Sync-/powermetering/(threads)

Thread 1 (2019-06-04):

error

Hojat1995, 2019-06-04:
hi,I am hojat and thank you for this project, i am working on ade9000 by arduino , i saw you have worked on stm so i downloaded that , but when i open eagle files that give me one error:

Loading C:/Users/hh/Downloads/powermetering-master/powermetering-master/stm32.sch ...

Error:

**line 1, column 1: Start tag expected.**

can you help me ,why?

luksal, 2019-06-04:
It's made with KiCAD not eagle

Sync-, 2019-06-04:
Luksal is correct, this project is designed in KiCAD.

Hojat1995, 2019-06-04:
oops, THANKS.I didn't know this software, I will download it and test it,THANKS again.    On Tuesday, June 4, 2019, 8:36:19 PM GMT+4:30, Sync- <notifications@github.com> wrote:

Closed #1.

—
You are receiving this because you authored the thread.
Reply to this email directly, view it on GitHub, or mute the thread.

Hojat1995, 2019-06-04:
My win recognize under software . Can you tell me which software do you use?I use altium and kail ,eagle and codvision and atmel are install.
    On Tuesday, June 4, 2019, 8:36:18 PM GMT+4:30, Sync- <notifications@github.com> wrote:

Luksal is correct, this project is designed in KiCAD.

—
You are receiving this because you authored the thread.
Reply to this email directly, view it on GitHub, or mute the thread.

Closed 2019-06-04.

Thread 2 (2019-06-05):

GPN19 slides

luksal, 2019-06-05:
I saw that there was a talk about this powermeter project at the GPN19, which is unfortunately not available as a recording. Is it possible to get the slides and other informations about this?

Sync-, 2019-06-05:
The slides are here: https://pretalx.entropia.de/gpn19/talk/TFASVY/
However there is not much information beyond what you can find in the git repo.

luksal, 2019-06-05:
Clicking on the slides link gives a 404

Sync-, 2019-06-05:
Huh, that seems like a problem on their end, I'll see what I can do.

Closed 2019-06-05.

Thread 3 (2019-06-20):

Stuff to fix

Sync-, 2019-06-20:
- [ ] Fix SPI connection

- [ ] Connect a Magjack LED to the PHY and STM

- [ ] Pinheader with GPIOs

- [ ] VTref for the debugger

- [ ] USB Host

- [ ] Ruggedness improvements (MOV, ESD)

Thread 4 (2019-09-07):

Add BOM or missing component values

joa77, 2019-09-07:
Can you add a complete BOM, add the missing values in the schematics or share a Digikey cart?

Thread 12 (2020-01-04):

Power Factor readout failed

MarkusBec, 2020-01-04:
After some time Power Factor readings Fail.
It can only be recovered by a reset of the STM.

MarkusBec, 2020-01-04:
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
