Sync-/powermetering/powermetering.kicad_pcb

## KiCad design powermetering.kicad_pcb (2020-01-22)

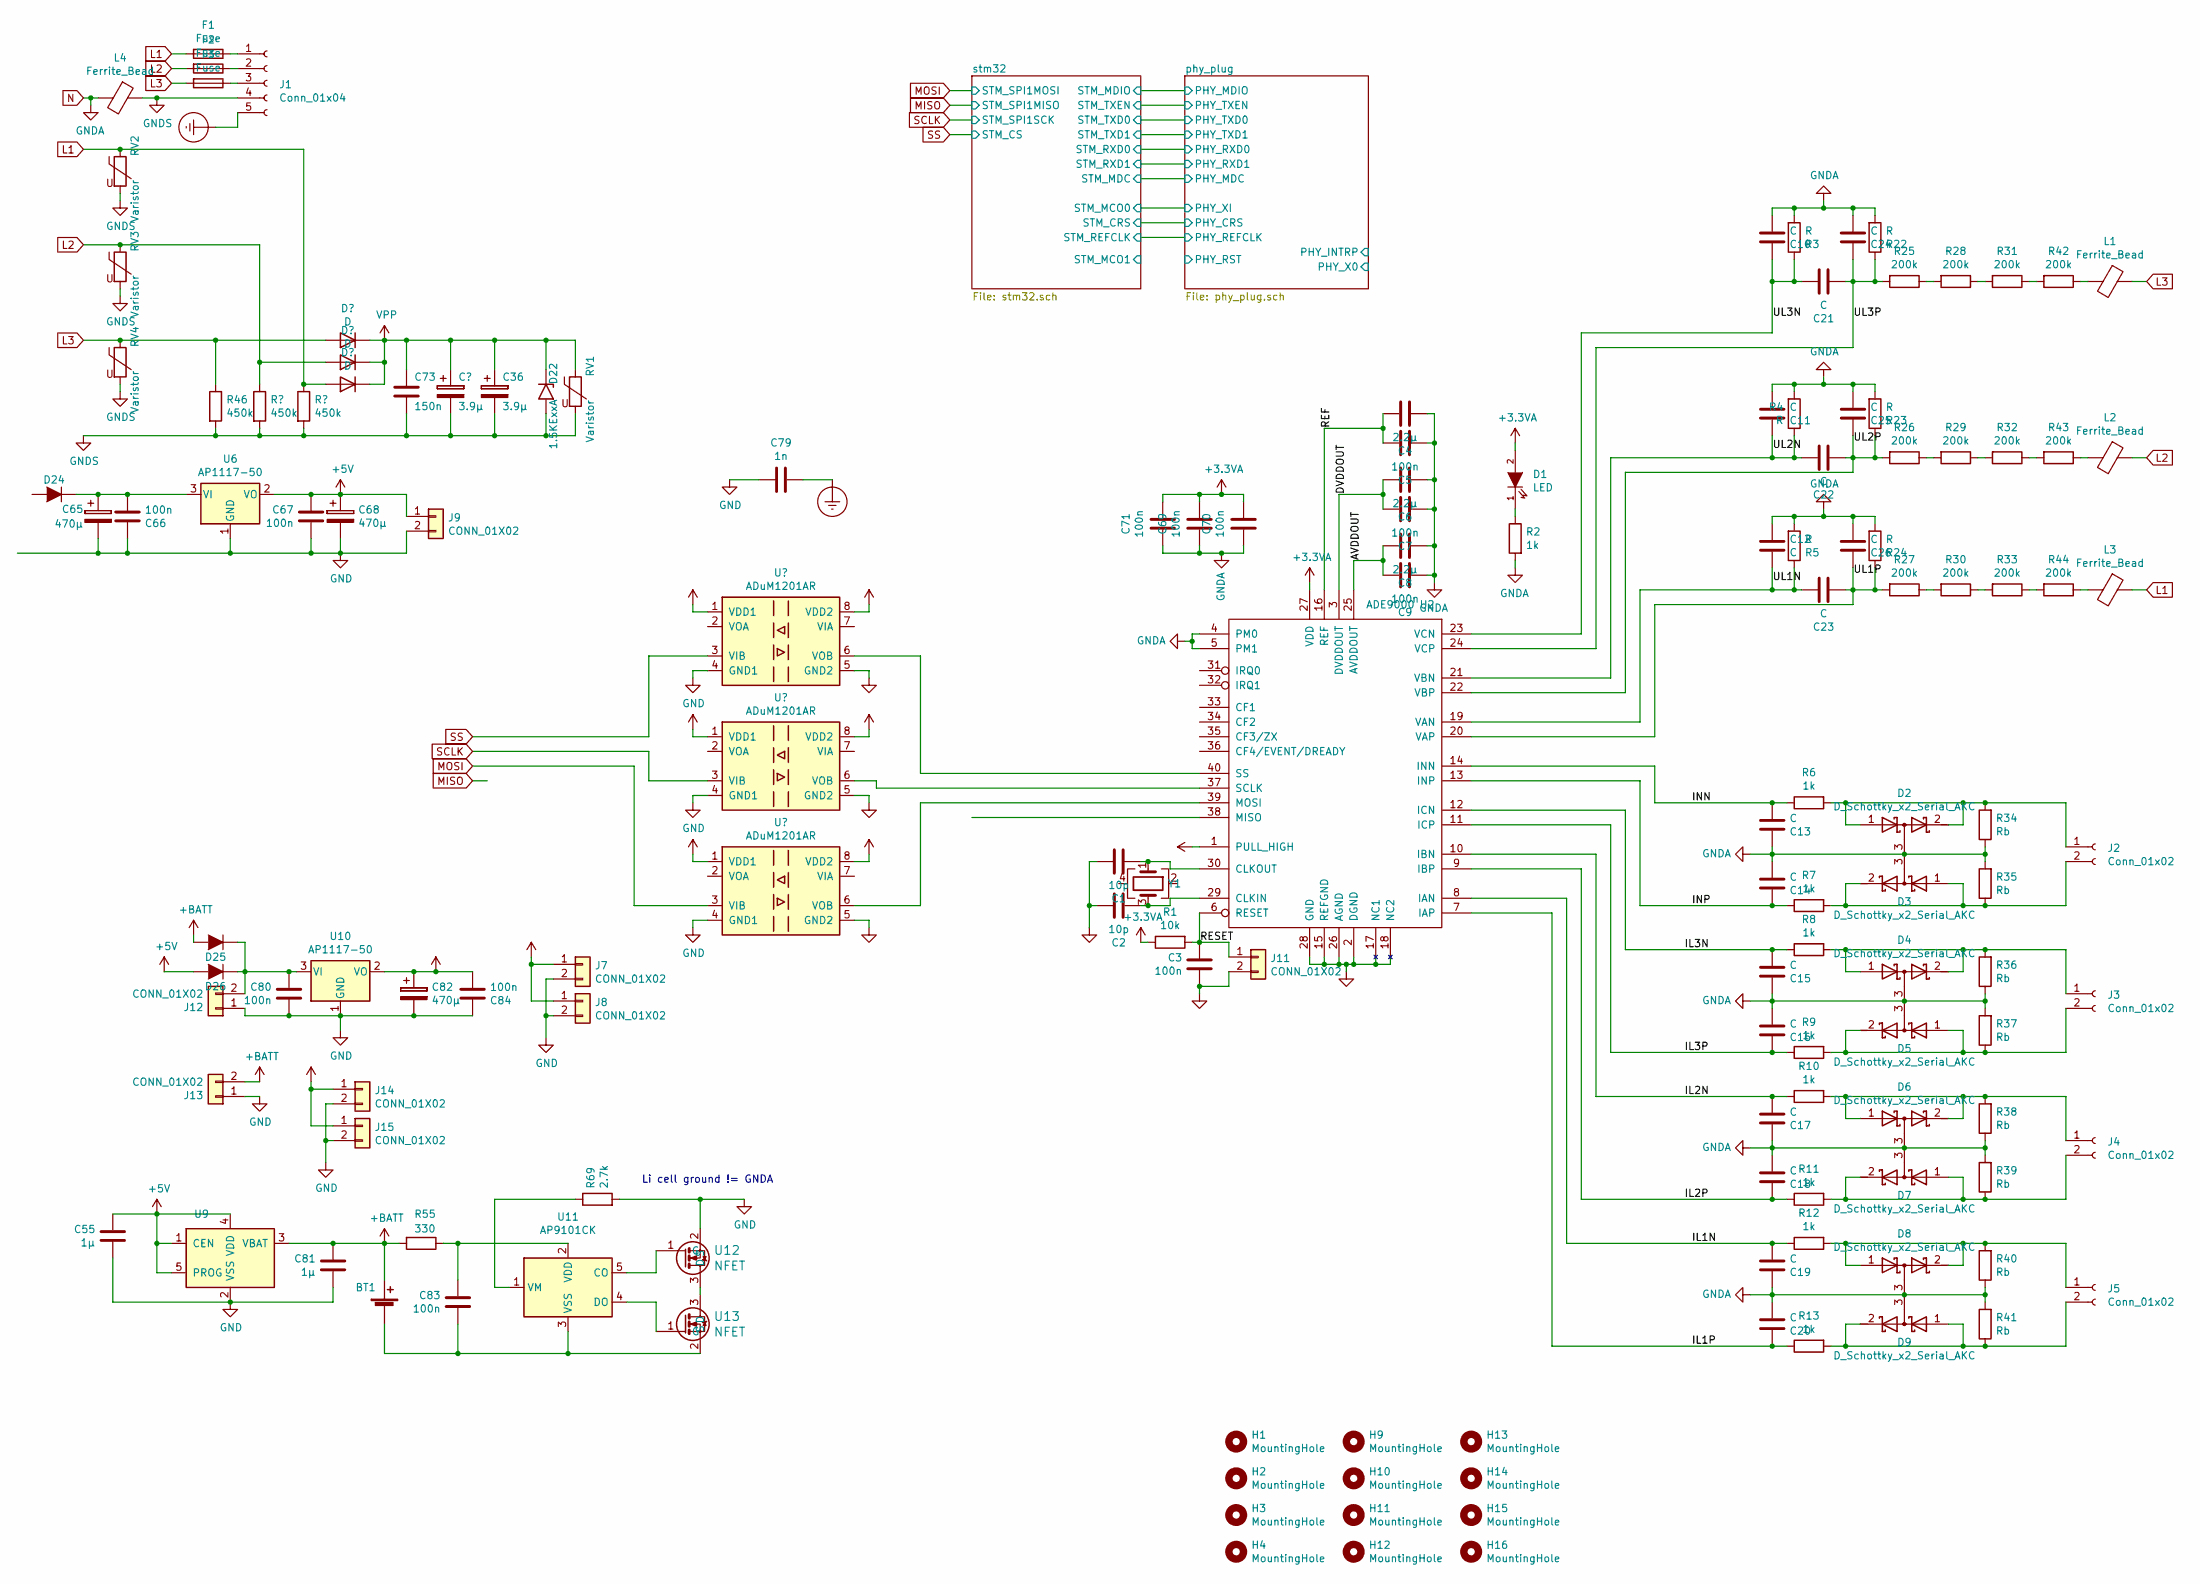
[picture p1: schematic powermetering.sch]

Parts:
BT1: Battery_Cell; 18650_keystone_54
C1, C2: 10p; C_0603
C3, C5, C7, C9, C69, C70, C71: 100n; C_0603
C4, C6, C8: 2.2µ; C_0603
C10, C11, C12, C13, C14, C15, C16, C17, C18, C19, C20, C21, C22, C23, C24, C25, C26: C; C_0603
C36: 3.9µ; CP_Elec_8x10
C55, C81: 1µ; C_0805
C65: 470µ; CP_Elec_8x10
C66, C67, C80, C83, C84: 100n; C_0805
C68, C82: 470µ; CP_Elec_8x10.5
C73: 150n; C_1808
C79: 1n; C_1806_4516Metric
D1: LED; LED-0805
D2, D3, D4, D5, D6, D7, D8, D9: D_Schottky_x2_Serial_AKC; SOT-23
D22: 1.5KExxA; D_SMC
D24, D25, D26: D; SMA_Standard
F1, F2, F3: Fuse; Fuse_SunFuse-6HP
H1, H2, H3, H4, H9, H10, H11, H12, H13, H14, H15, H16: MountingHole; MountingHole_5.5mm
J1: Conn_01x04; RM5.08_1x5_UP
J2, J3, J4, J5: Conn_01x02; RM5.08_1x2_UP
J7, J8, J9, J11, J12, J13, J14, J15: CONN_01X02; Pin_Header_Straight_1x02
L1, L2, L3, L4: Ferrite_Bead; C_0805
R1: 10k; R_0603
R2, R6, R7, R8, R9, R10, R11, R12, R13: 1k; R_0603
R3, R4, R5, R22, R23, R24: R; R_0603
R25, R26, R27, R28, R29, R30, R31, R32, R33, R42, R43, R44: 200k; R_1206
R34, R35, R36, R37, R38, R39, R40, R41: Rb; R_0612_1632Metric
R46: 450k; R_1206
R55: 330; R_0805
R69: 2.7k; R_0805
RV1, RV2, RV3, RV4: Varistor; RV_Disc_D12mm_W3.9mm_P7.5mm
U2: ADE9000; QFN-40-1EP_6x6mm_Pitch0.5mm
U6, U10: AP1117-50; SOT-223-3_TabPin2
U9: MCP73811T-420I-OT; SOT-23-5
U11: AP9101CK; SOT-23-5
U12, U13: NFET; SOT-23
Y1: Crystal; Crystal_SMD_3225-4Pin_3.2x2.5mm

Connections:
+3.3VA: C69.2, C70.2, C71.2, D1.2 (A), R1.1, U2.1 (PULL_HIGH), U2.27 (VDD); also elsewhere on the board
+3V3: C82.1, C84.2, J7.1, J8.1, J14.1, J15.1, U10.2 (VO); also elsewhere on the board
+5V: C55.1, C67.1, C68.1, D26.2 (A), J9.1, U6.2 (VO), U9.1 (CEN), U9.4 (VDD), U9.5 (PROG)
+BATT: BT1.1 (+), C81.1, D25.2 (A), J13.2, R55.2, U9.3 (VBAT)
/AVDDOUT: C8.2, C9.2, U2.25 (AVDDOUT)
/DVDDOUT: C6.2, C7.2, U2.3 (DVDDOUT)
/IL1N: C19.1, R12.1, U2.8 (IAN)
/IL1P: C20.2, R13.1, U2.7 (IAP)
/IL2N: C17.1, R10.1, U2.10 (IBN)
/IL2P: C18.2, R11.1, U2.9 (IBP)
/IL3N: C15.1, R8.1, U2.12 (ICN)
/IL3P: C16.2, R9.1, U2.11 (ICP)
/INN: C13.1, R6.1, U2.14 (INN)
/INP: C14.2, R7.1, U2.13 (INP)
/REF: C4.2, C5.2, U2.16 (REF)
/RESET: C3.2, J11.1, R1.2, U2.6 (RESET)
/UL1N: C12.2, C23.2, R5.1, U2.19 (VAN)
/UL1P: C23.1, C26.2, R24.1, R27.2, U2.20 (VAP)
/UL2N: C11.2, C22.2, R4.1, U2.21 (VBN)
/UL2P: C22.1, C25.2, R23.1, R26.2, U2.22 (VBP)
/UL3N: C10.2, C21.2, R3.1, U2.23 (VCN)
/UL3P: C21.1, C24.2, R22.1, R25.2, U2.24 (VCP)
Earth_Protective: C79.2, J1.5
GND: C55.2, C65.2, C66.1, C67.2, C68.2, C79.1, C80.2, C81.2, C82.2, C84.1, J7.2, J8.2, J9.2, J12.1, J13.1, J14.2, J15.2, R69.2, U6.1 (GND), U9.2 (VSS), U10.1 (GND), U12.2 (S); also elsewhere on the board
L1: F1.2, L3.1, RV2.1; also elsewhere on the board
L2: F2.2, L2.1, RV3.1; also elsewhere on the board
N: C1.2, C2.2, C3.1, C4.1, C5.1, C6.1, C7.1, C8.1, C9.1, C10.1, C11.1, C12.1, C13.2, C14.1, C15.2, C16.1, C17.2, C18.1, C19.2, C20.1, C24.1, C25.1, C26.1, C69.1, C70.1, C71.1, D2.3 (common), D3.3 (common), D4.3 (common), D5.3 (common), D6.3 (common), D7.3 (common), D8.3 (common), D9.3 (common), J11.2, L4.2, R2.2, R3.2, R4.2, R5.2, R22.2, R23.2, R24.2, R34.1, R35.2, R36.1, R37.2, R38.1, R39.2, R40.1, R41.2, U2.2 (DGND), U2.4 (PM0), U2.5 (PM1), U2.15 (REFGND), U2.17 (NC1), U2.18 (NC2), U2.26 (AGND), U2.28 (GND); also elsewhere on the board
unnamed: BT1.2 (-), C83.2, U11.3 (VSS), U13.2 (S)
unnamed: C1.1, U2.30 (CLKOUT), Y1.1
unnamed: C2.1, U2.29 (CLKIN), Y1.3
unnamed: C65.1, C66.2, D24.1 (K), U6.3 (VI)
unnamed: C80.1, D25.1 (K), D26.1 (K), J12.2, U10.3 (VI)
unnamed: C83.1, R55.1, U11.2 (VDD)
unnamed: D1.1 (K), R2.1
unnamed: D2.1 (A), D2.2 (K), J2.1, R6.2, R34.2
unnamed: D3.1 (A), D3.2 (K), J2.2, R7.2, R35.1
unnamed: D4.1 (A), D4.2 (K), J3.1, R8.2, R36.2
unnamed: D5.1 (A), D5.2 (K), J3.2, R9.2, R37.1
unnamed: D6.1 (A), D6.2 (K), J4.1, R10.2, R38.2
unnamed: D7.1 (A), D7.2 (K), J4.2, R11.2, R39.1
unnamed: D8.1 (A), D8.2 (K), J5.1, R12.2, R40.2
unnamed: D9.1 (A), D9.2 (K), J5.2, R13.2, R41.1
unnamed: F1.1, J1.1
unnamed: F2.1, J1.2
unnamed: F3.1, J1.3
unnamed: L1.2, R42.1
unnamed: L2.2, R43.1
unnamed: L3.2, R44.1
unnamed: R25.1, R28.2
unnamed: R26.1, R29.2
unnamed: R27.1, R30.2
unnamed: R28.1, R31.2
unnamed: R29.1, R32.2
unnamed: R30.1, R33.2
unnamed: R31.1, R42.2
unnamed: R32.1, R43.2
unnamed: R33.1, R44.2
unnamed: R69.1, U11.1 (VM)
unnamed 160: U2.37 (SCLK); also elsewhere on the board
unnamed 161: U2.38 (MISO); also elsewhere on the board
unnamed 162: U2.39 (MOSI); also elsewhere on the board
unnamed 163: U2.40 (SS); also elsewhere on the board
unnamed: U11.4 (DO), U13.1 (G)
unnamed: U11.5 (CO), U12.1 (G)
unnamed: U12.3 (D), U13.3 (D)

Notes on the sheet:
Li cell ground != GNDA

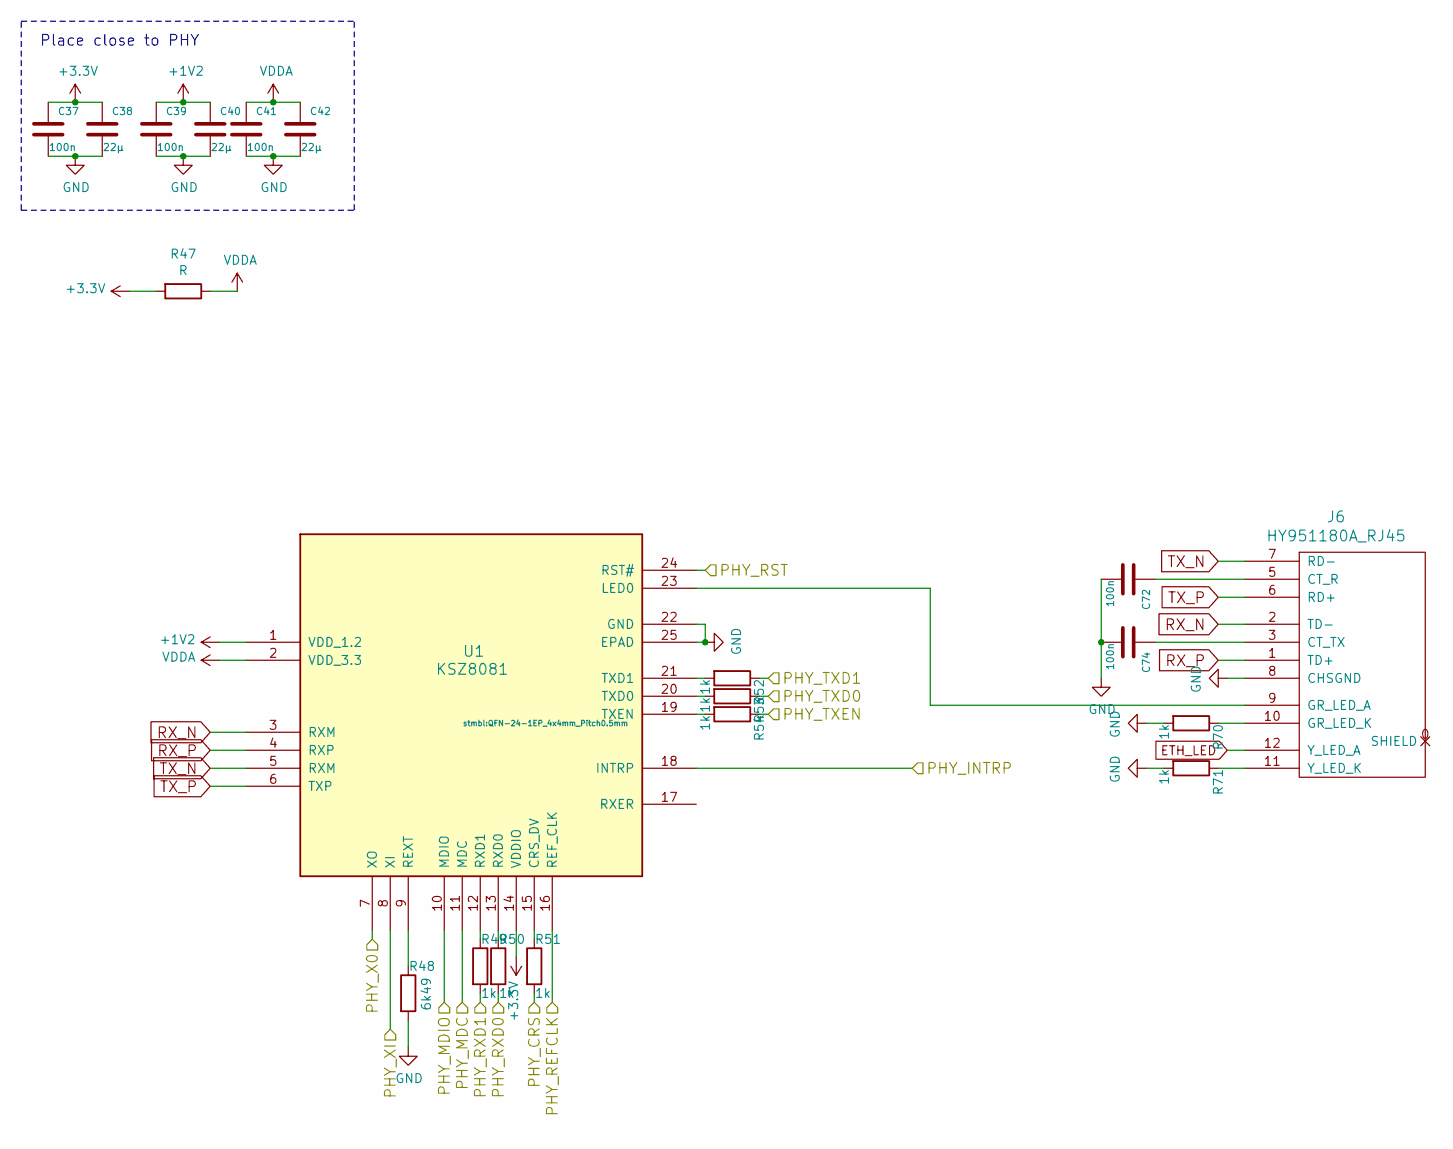
[picture p2: schematic phy_plug.sch]

Parts:
C37, C39, C41, C72, C74: 100n; C_0603
C38, C40, C42: 22µ; C_0805
J6: HY951180A_RJ45
R47: R; R_0603
R48: 6k49; R_0603
R49, R50, R51, R52, R53, R54, R70, R71: 1k; R_0603
U1: KSZ8081; QFN-24-1EP_4x4mm_Pitch0.5mm

Connections:
+1V2: C39.1, C40.1, U1.1 (VDD_1.2)
+3V3: C37.1, C38.1, R47.2, U1.14 (VDDIO); also elsewhere on the board
/PHY_CRS: R51.2; also elsewhere on the board
/PHY_INTRP: U1.18 (INTRP)
/PHY_MDIO: U1.10 (MDIO); also elsewhere on the board
/PHY_RST: U1.24 (RST#)
/PHY_TXD0: R53.1; also elsewhere on the board
/PHY_X0: U1.7 (XO)
/PHY_XI: U1.8 (XI); also elsewhere on the board
/STM_MDC: U1.11 (MDC); also elsewhere on the board
/STM_REFCLK: U1.16 (REF_CLK); also elsewhere on the board
/STM_RXD0: R50.2; also elsewhere on the board
/STM_RXD1: R49.2; also elsewhere on the board
/STM_TXD1: R52.1; also elsewhere on the board
/STM_TXEN: R54.1; also elsewhere on the board
ETH_LED: J6.12 (Y_LED_A); also elsewhere on the board
GND: C37.2, C38.2, C39.2, C40.2, C41.2, C42.2, C72.2, C74.2, J6.8 (CHSGND), R48.2, R70.2, R71.2, U1.22 (GND), U1.25 (EPAD); also elsewhere on the board
unnamed: C72.1, J6.5 (CT_R)
unnamed: C74.1, J6.3 (CT_TX)
unnamed: J6.9 (GR_LED_A), U1.23 (LED0)
unnamed: J6.10 (GR_LED_K), R70.1
unnamed: J6.11 (Y_LED_K), R71.1
unnamed: R48.1, U1.9 (REXT)
unnamed: R49.1, U1.12 (RXD1)
unnamed: R50.1, U1.13 (RXD0)
unnamed: R51.1, U1.15 (CRS_DV)
unnamed: R52.2, U1.21 (TXD1)
unnamed: R53.2, U1.20 (TXD0)
unnamed: R54.2, U1.19 (TXEN)
RX_N: J6.2 (TD-), U1.3 (RXM)
RX_P: J6.1 (TD+), U1.4 (RXP)
TX_N: J6.7 (RD-), U1.5 (RXM)
TX_P: J6.6 (RD+), U1.6 (TXP)
VDDA: C41.1, C42.1, R47.1, U1.2 (VDD_3.3)

Notes on the sheet:
Place close to PHY

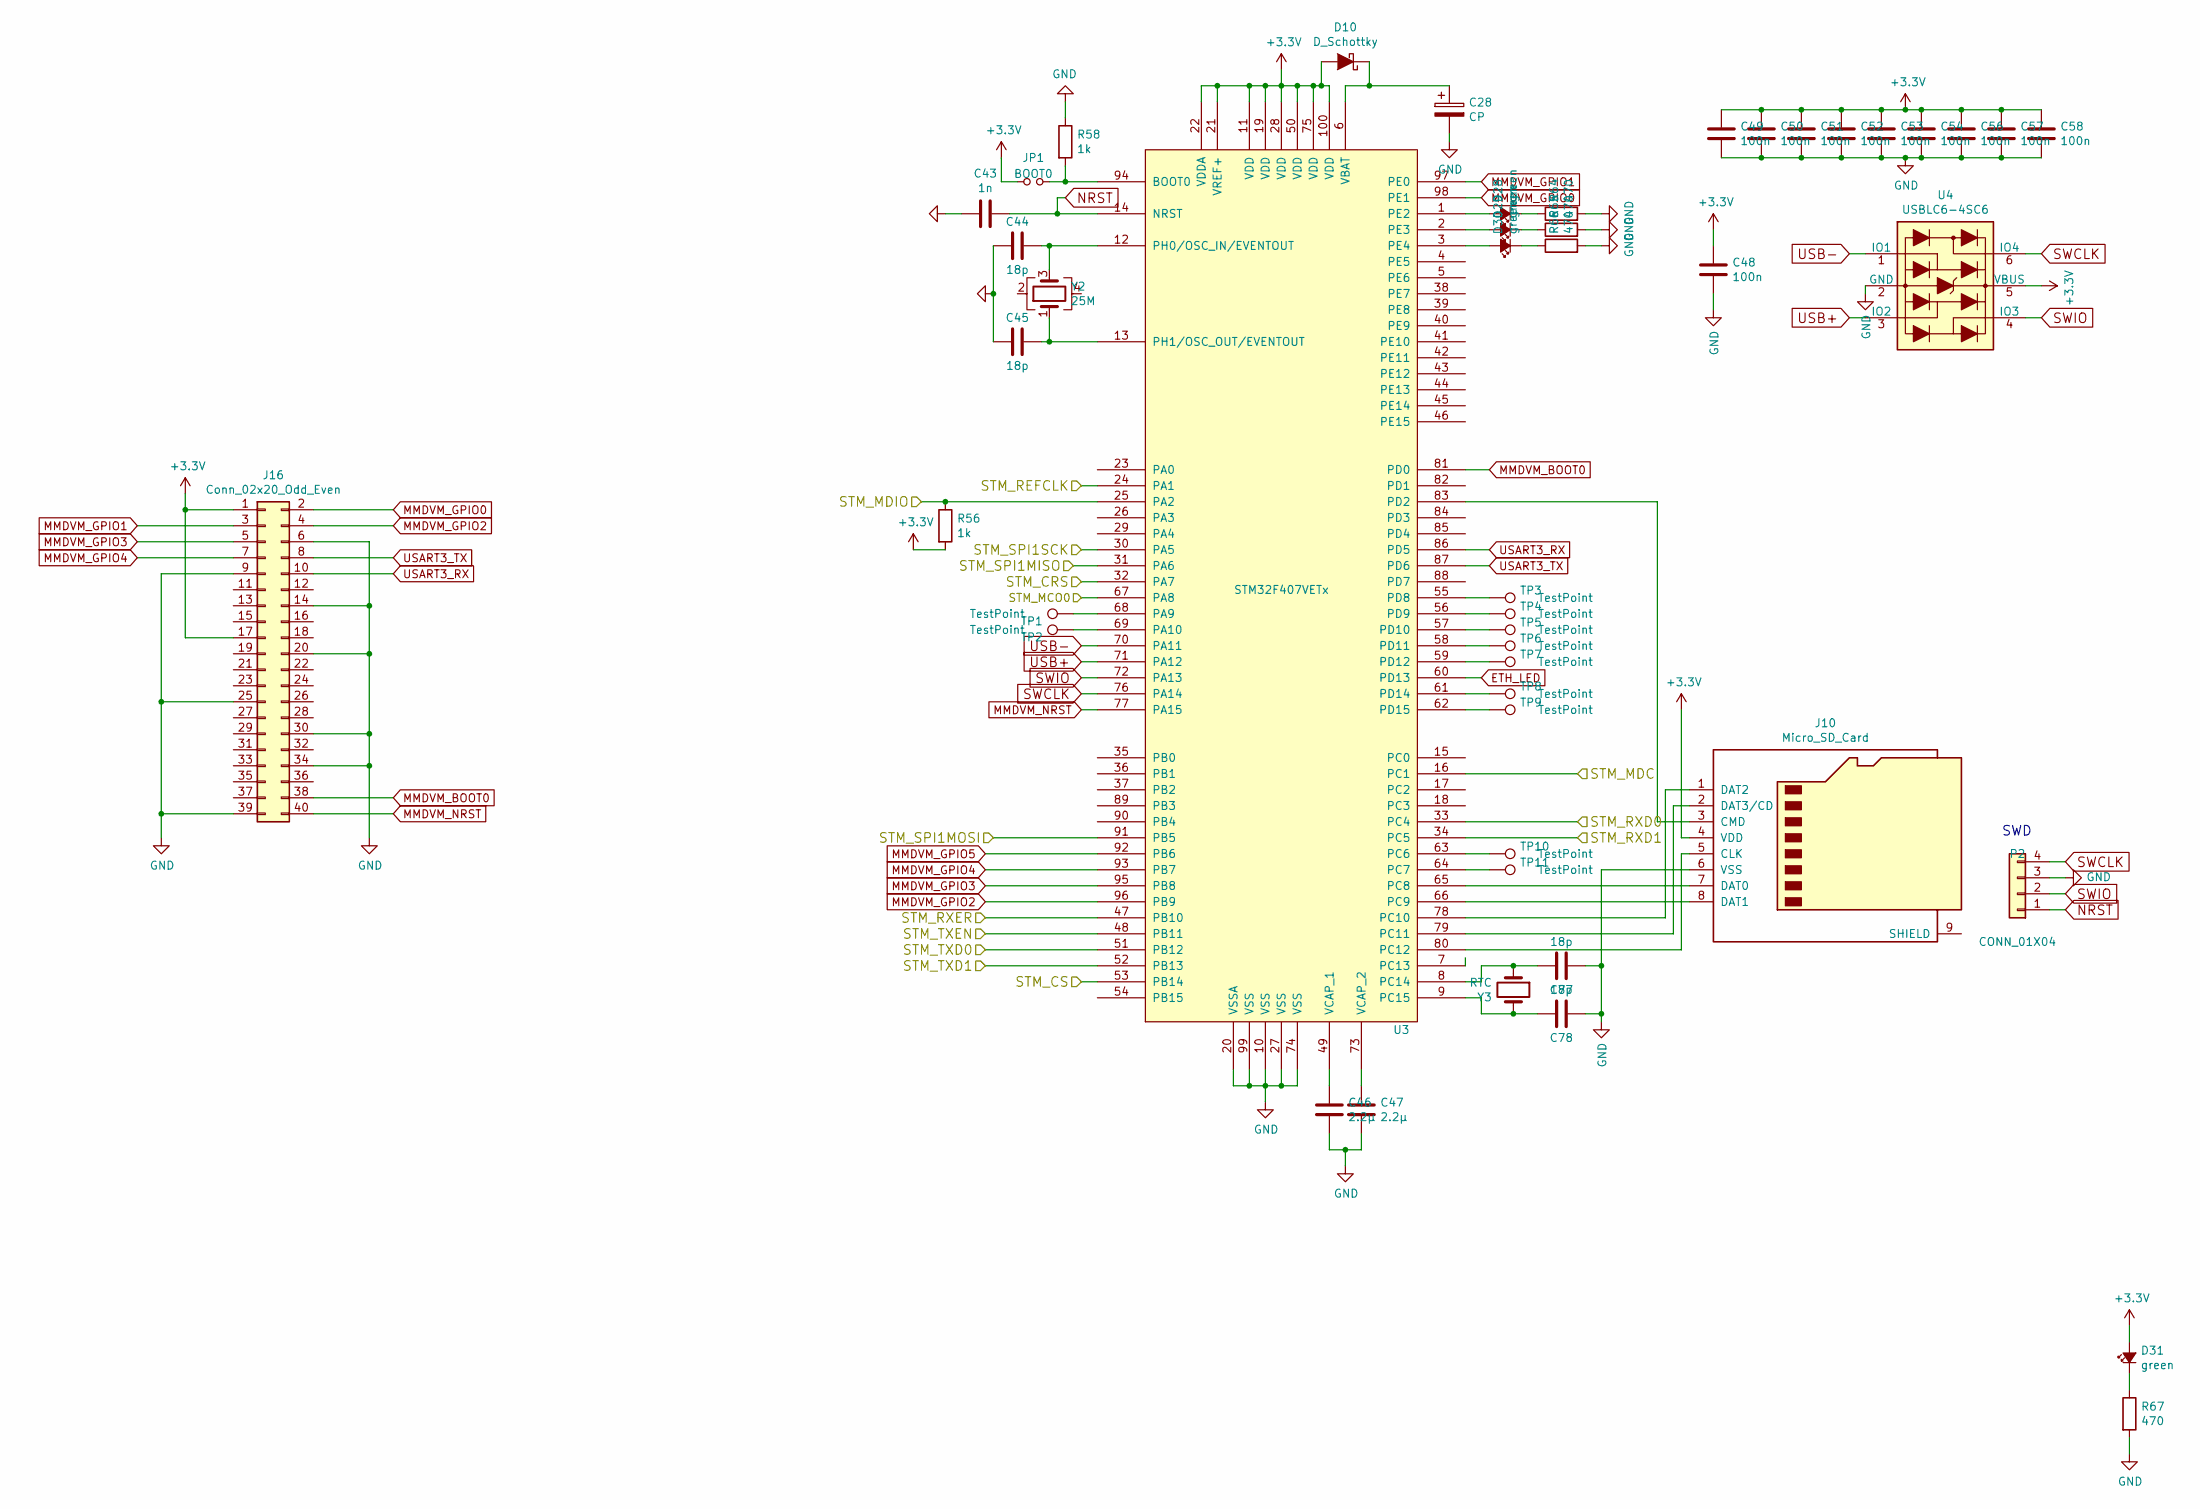
[picture p3: schematic stm32.sch, STM32 Ethernet BOB]

Parts:
C28: CP
C43: 1n; C_0603; Tolerance X5R; Voltage 50V
C44, C45, C77, C78: 18p; C_0603; Tolerance X5R; Voltage 50V
C46, C47: 2.2µ; C_0603; Tolerance X5R; Voltage 25V
C48, C49, C50, C51, C52, C53, C54, C56, C57, C58: 100n; C_0603; Tolerance X5R; Voltage 50V
D10: D_Schottky
D28, D29, D30, D31: green; LED-0805
J10: Micro_SD_Card; microSD_HC_Hirose_DM3BT-DSF-PEJS
J16: Conn_02x20_Odd_Even; PinHeader_2x20_P2.54mm_Vertical
JP1: BOOT0; SOLDER_JUMPER
P2: CONN_01X04; Pin_Header_Straight_1x04
R56, R58: 1k; R_0603; Tolerance 1%
R64, R65, R66, R67: 470; R_0603; Tolerance 1%
TP1, TP2, TP3, TP4, TP5, TP6, TP7, TP8, TP9, TP10, TP11: TestPoint; TestPoint_Pad_D1.0mm
U3: STM32F407VETx; LQFP-100_14x14mm_Pitch0.5mm
U4: USBLC6-4SC6; SOT-23-6
Y2: 25M; Crystal_SMD_3225-4Pin_3.2x2.5mm
Y3: RTC; Crystal_SMD_3215-2Pin_3.2x1.5mm

Connections:
+3V3: C48.2, C49.2, C50.2, C51.2, C52.2, C53.2, C54.2, C56.2, C57.2, C58.2, D10.2 (A), D31.2 (A), J10.4 (VDD), J16.1, J16.17, JP1.2, R56.2, U3.11 (VDD), U3.19 (VDD), U3.21 (VREF+), U3.22 (VDDA), U3.28 (VDD), U3.50 (VDD), U3.75 (VDD), U3.100 (VDD), U4.5 (VBUS); also elsewhere on the board
/PHY_CRS: U3.32 (PA7); also elsewhere on the board
/PHY_MDIO: R56.1, U3.25 (PA2); also elsewhere on the board
/PHY_TXD0: U3.51 (PB12); also elsewhere on the board
/PHY_XI: U3.67 (PA8); also elsewhere on the board
/STM_MDC: U3.16 (PC1); also elsewhere on the board
/STM_REFCLK: U3.24 (PA1); also elsewhere on the board
/STM_RXD0: U3.33 (PC4); also elsewhere on the board
/STM_RXD1: U3.34 (PC5); also elsewhere on the board
/STM_TXD1: U3.52 (PB13); also elsewhere on the board
/STM_TXEN: U3.48 (PB11); also elsewhere on the board
/stm32/STM_RXER: U3.47 (PB10)
ETH_LED: U3.60 (PD13); also elsewhere on the board
GND: C28.2, C43.2, C44.2, C45.2, C46.1, C47.1, C48.1, C49.1, C50.1, C51.1, C52.1, C53.1, C54.1, C56.1, C57.1, C58.1, C77.2, C78.2, J10.6 (VSS), J16.6, J16.9, J16.14, J16.20, J16.25, J16.30, J16.34, J16.39, P2.3, R58.1, R64.2, R65.2, R66.2, R67.2, U3.10 (VSS), U3.20 (VSSA), U3.27 (VSS), U3.74 (VSS), U3.99 (VSS), U4.2 (GND); also elsewhere on the board
MISO: U3.31 (PA6); also elsewhere on the board
MMDVM_BOOT0: J16.38, U3.81 (PD0)
MMDVM_GPIO0: J16.2, U3.98 (PE1)
MMDVM_GPIO1: J16.3, U3.97 (PE0)
MMDVM_GPIO2: J16.4, U3.96 (PB9)
MMDVM_GPIO3: J16.5, U3.95 (PB8)
MMDVM_GPIO4: J16.7, U3.93 (PB7)
MMDVM_GPIO5: U3.92 (PB6)
MMDVM_NRST: J16.40, U3.77 (PA15)
MOSI: U3.91 (PB5); also elsewhere on the board
NRST: C43.1, P2.1, U3.14 (NRST)
unnamed: C28.1, D10.1 (K), U3.6 (VBAT)
unnamed: C44.1, U3.12 (PH0/OSC_IN/EVENTOUT), Y2.3
unnamed: C45.1, U3.13 (PH1/OSC_OUT/EVENTOUT), Y2.1
unnamed: C46.2, U3.49 (VCAP_1)
unnamed: C47.2, U3.73 (VCAP_2)
unnamed: C77.1, U3.8 (PC14), Y3.1
unnamed: C78.1, U3.9 (PC15), Y3.2
unnamed: D28.1 (K), R64.1
unnamed: D28.2 (A), U3.1 (PE2)
unnamed: D29.1 (K), R65.1
unnamed: D29.2 (A), U3.2 (PE3)
unnamed: D30.1 (K), R66.1
unnamed: D30.2 (A), U3.3 (PE4)
unnamed: D31.1 (K), R67.1
unnamed: J10.1 (DAT2), U3.78 (PC10)
unnamed: J10.2 (DAT3/CD), U3.79 (PC11)
unnamed: J10.3 (CMD), U3.83 (PD2)
unnamed: J10.5 (CLK), U3.80 (PC12)
unnamed: J10.7 (DAT0), U3.65 (PC8)
unnamed: J10.8 (DAT1), U3.66 (PC9)
unnamed: JP1.1, R58.2, U3.94 (BOOT0)
unnamed: TP1.1, U3.68 (PA9)
unnamed: TP2.1, U3.69 (PA10)
unnamed: TP3.1, U3.55 (PD8)
unnamed: TP4.1, U3.56 (PD9)
unnamed: TP5.1, U3.57 (PD10)
unnamed: TP6.1, U3.58 (PD11)
unnamed: TP7.1, U3.59 (PD12)
unnamed: TP8.1, U3.61 (PD14)
unnamed: TP9.1, U3.62 (PD15)
unnamed: TP10.1, U3.63 (PC6)
unnamed: TP11.1, U3.64 (PC7)
SCLK: U3.30 (PA5); also elsewhere on the board
SS: U3.53 (PB14); also elsewhere on the board
SWCLK: P2.4, U3.76 (PA14), U4.6 (IO4)
SWIO: P2.2, U3.72 (PA13), U4.4 (IO3)
USART3_RX: J16.10, U3.86 (PD5)
USART3_TX: J16.8, U3.87 (PD6)
USB+: U3.71 (PA12), U4.3 (IO2)
USB-: U3.70 (PA11), U4.1 (IO1)

Notes on the sheet:
SWD

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
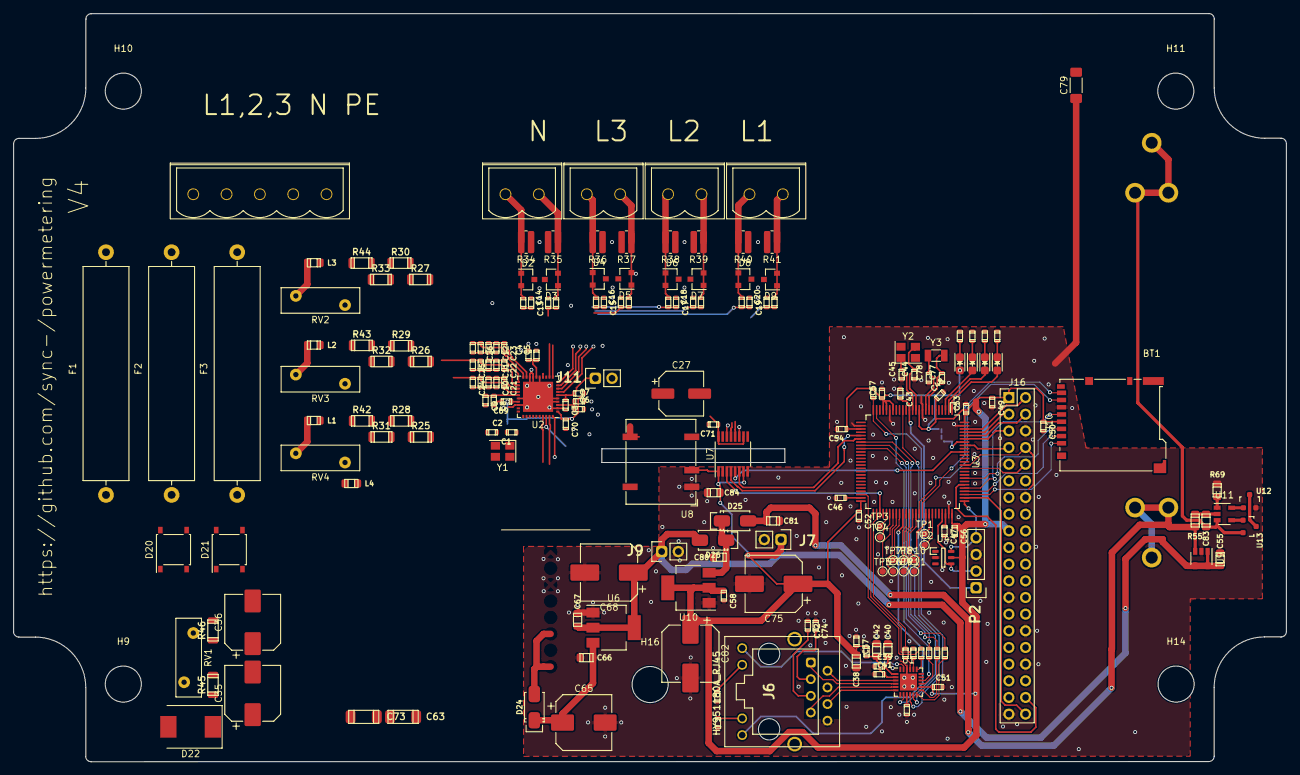
[picture p4: board powermetering.kicad_pcb from above]

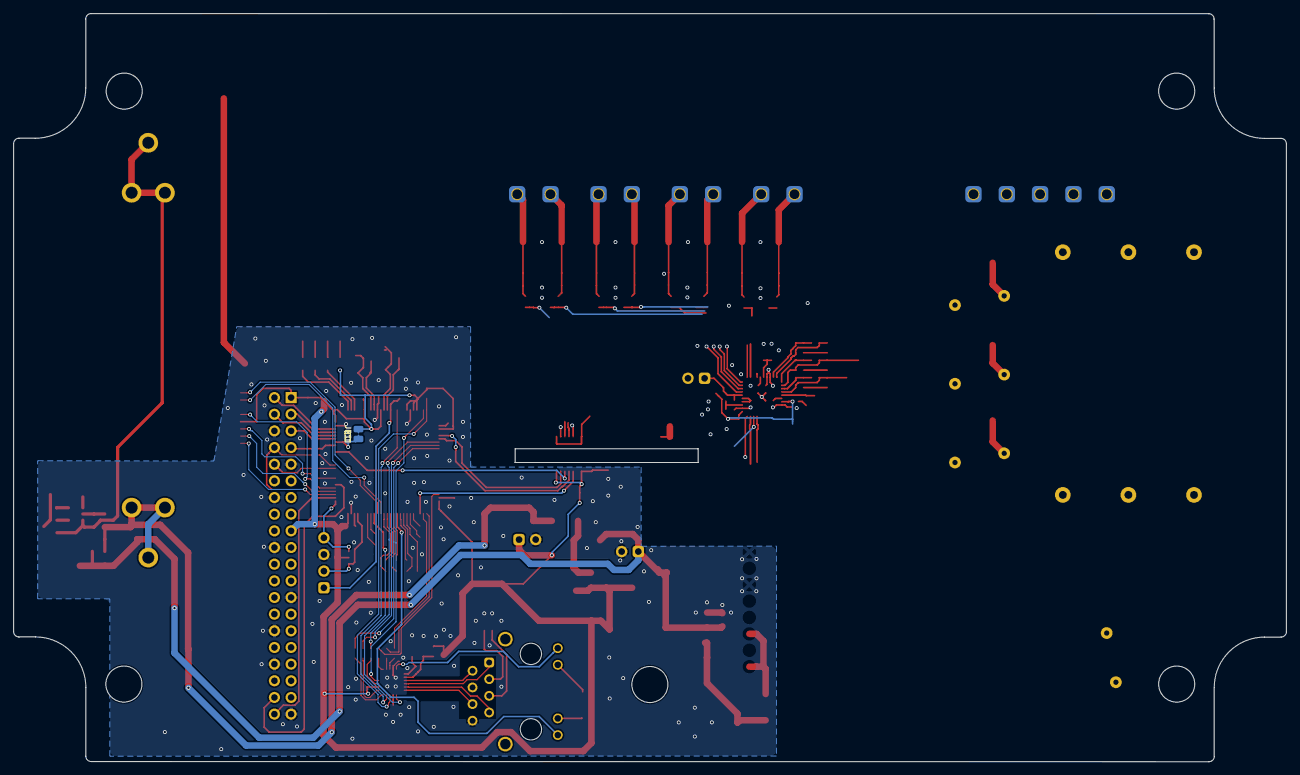
[picture p5: board powermetering.kicad_pcb from below]

Board: 2 copper layers, 194.0 x 114.1 mm, 200 parts (2 on the bottom side), 147 nets.

Other parts of the board:
C27: 470µ; CP_Elec_6.3x5.9
C35: 3.9µ; CP_Elec_8x10
C63: 150n; C_1808
C75: 470µ; CP_Elec_8x10.5
D20, D21: ABS10; Diode_Bridge_Diotec_ABS
R45: 450k; R_1206
U7: Si8641EB-B-IU; QSOP-16_3.9x4.9mm_P0.635mm
U8: NXE2S0505MC; Converter_DCDC_muRata_NXE2SxxxxMC_THT

Their connections:
+3.3VA: C27.1, U7.10, U7.16, U8.8; also elsewhere on the board
+3V3: C75.1, U7.1, U7.7, U8.3; also elsewhere on the board
GND: C75.2, U7.2, U7.8, U8.1; also elsewhere on the board
L1: D20.4; also elsewhere on the board
L2: D20.3; also elsewhere on the board
MISO: U7.6; also elsewhere on the board
MOSI: U7.5; also elsewhere on the board
N: C27.2, U7.9, U7.15, U8.7; also elsewhere on the board
unnamed 160: U7.13; also elsewhere on the board
unnamed 161: U7.11; also elsewhere on the board
unnamed 162: U7.12; also elsewhere on the board
unnamed 163: U7.14; also elsewhere on the board
SCLK: U7.4; also elsewhere on the board
SS: U7.3; also elsewhere on the board
