Sync-/powermetering/software/powermetering/Core/Src/main.c

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

/* Includes ------------------------------------------------------------------*/
#include "main.h"
#include "cmsis_os.h"
#include "crc.h"
#include "i2c.h"
#include "rtc.h"
#include "sdio.h"
#include "spi.h"
#include "gpio.h"

/* USER CODE BEGIN Includes */
#include "httpd.h"
#include "def.h"
#include "config.h"
#include "SEGGER_RTT.h"
#include "ADE9000.h"
#include "fs.h"
#include "string.h"
#include "influx.h"
//#include "dmr.h"
#include "ade.h"
#include "fwupdate.h"
#include "lwip.h"
#include "netif.h"
#include <math.h>
/* USER CODE END Includes */


void SystemClock_Config(void);
/* USER CODE BEGIN 0 */
//rtos heap in ccm
uint8_t ucHeap[configTOTAL_HEAP_SIZE] __attribute__((section(".ccmram")));

//check if malloc locks can be overwritten, do not remove this check
#ifndef _RETARGETABLE_LOCKING
#error "newlib must be configured with --enable-newlib-retargetable-locking"
#endif

void __malloc_lock(struct _reent *r)
{
    vTaskSuspendAll();
}


void __malloc_unlock(struct _reent *r)
{
    xTaskResumeAll();
}


void LEDBlink(void)
{
  while (1)
  {
    HAL_GPIO_TogglePin(LED1_GPIO_Port, LED1_Pin);
    vTaskDelay(100);
  }
}

void linktask(void)
{
  uint32_t reg;
  uint32_t link = 0;
  extern struct netif gnetif;
  extern struct dhcp dhcpstruct;
  extern uint8_t network_state;
  extern ETH_HandleTypeDef heth;
  extern ip4_addr_t ipaddr;
  extern ip4_addr_t netmask;
  extern ip4_addr_t gw;
  extern uint8_t IP_ADDRESS[4];
  extern uint8_t NETMASK_ADDRESS[4];
  extern uint8_t GATEWAY_ADDRESS[4];

  while (1) {
    HAL_ETH_ReadPHYRegister(&heth, PHY_SR, &reg);
    if ((reg & 256)){
      if (link == 0){
        link = 1;
        HAL_GPIO_WritePin(LED2_GPIO_Port, LED2_Pin, 1);
        SEGGER_RTT_printf(0, "Link goes up\n");

        char ip_name[CONFIG_STRINGLENGTH];
        config_get_string("name", ip_name);
        netif_set_hostname(&gnetif, ip_name);

        dhcp_start(&gnetif);
        network_state = 1; //dhcp_started
        SEGGER_RTT_printf(0, "DHCP started\n");
        vTaskDelay(15000);
      }
    }else{
      link = 0;
      HAL_GPIO_WritePin(LED2_GPIO_Port, LED2_Pin, 0);
      SEGGER_RTT_printf(0, "Link goes down\n");
      netif_set_link_down(&gnetif);

      dhcp_stop(&gnetif);
      network_state = 0; //dhcp_off
      SEGGER_RTT_printf(0, "Link is down\n");
    }

    if (network_state == 1 && (dhcp_supplied_address(&gnetif) == 1)){
      SEGGER_RTT_printf(0, "DHCP got IP\n");
      network_state = 2; //dhcp_started

      ipaddr = dhcpstruct.offered_ip_addr;
      netmask = dhcpstruct.offered_sn_mask;
      gw = dhcpstruct.offered_gw_addr;

      char* ip = ip4addr_ntoa(&ipaddr);
      SEGGER_RTT_printf(0,"%s\n",ip);

      netif_set_up(&gnetif);
      netif_set_link_up(&gnetif);
      SEGGER_RTT_printf(0, "DHCP UP\n");
    }else if (network_state == 1 && (dhcp_supplied_address(&gnetif) == 0)){
      SEGGER_RTT_printf(0, "DHCP no ip\n");
      network_state = 3; //dhcp_fixedip

      char ip_string[CONFIG_STRINGLENGTH];
      config_get_string("ip", ip_string);
      if(!ip4addr_aton(ip_string, &ipaddr)){
        IP4_ADDR(&ipaddr, IP_ADDRESS[0], IP_ADDRESS[1], IP_ADDRESS[2], IP_ADDRESS[3]);
      }
      char* ip = ip4addr_ntoa(&ipaddr);
      SEGGER_RTT_printf(0,"%s\n",ip);
      IP4_ADDR(&netmask, NETMASK_ADDRESS[0], NETMASK_ADDRESS[1] , NETMASK_ADDRESS[2], NETMASK_ADDRESS[3]);
      IP4_ADDR(&gw, GATEWAY_ADDRESS[0], GATEWAY_ADDRESS[1], GATEWAY_ADDRESS[2], GATEWAY_ADDRESS[3]);

      dhcp_inform(&gnetif);

      netif_set_up(&gnetif);
      netif_set_link_up(&gnetif);
      SEGGER_RTT_printf(0, "Static IP\n");
    }
    vTaskDelay(100);
  }
}

//static void *current_connection;
//static void *valid_connection;

err_t httpd_post_begin(void *connection, const char *uri, const char *http_request,
                 u16_t http_request_len, int content_len, char *response_uri,
                 u16_t response_uri_len, u8_t *post_auto_wnd)
{
  LWIP_UNUSED_ARG(connection);
  LWIP_UNUSED_ARG(http_request);
  LWIP_UNUSED_ARG(http_request_len);
  LWIP_UNUSED_ARG(content_len);
  LWIP_UNUSED_ARG(post_auto_wnd);
  SEGGER_RTT_printf(0, "httpd_post_begin: %s %i\n", uri, content_len);

  return ERR_OK;
}
extern uint32_t ade_reconfigure;
err_t httpd_post_receive_data(void *connection, struct pbuf *p)
{
  //p->payload is not a null terminated string, this prints garbage
  //SEGGER_RTT_printf(0, "httpd_post_receive_data: %u %s\n", p->tot_len,p->payload);
  config_write(p->payload,p->tot_len);
  ade_reconfigure = 1;
  pbuf_free(p);
  return ERR_OK;
}

void httpd_post_finished(void *connection, char *response_uri, u16_t response_uri_len)
{
  snprintf(response_uri, response_uri_len, "/config.shtml");
  SEGGER_RTT_printf(0, "httpd_post_finished\n");
}



char* tags[] = {"STAT","CONFIG","NAME", "PKTCNT", "PHASOR", "VERSION", "RESET"};

uint16_t ssi_handler(uint32_t index, char *insert, uint32_t insertlen)
{
 if(index == 0){//STAT
    uint32_t len = 0;
    len += snprintf(insert + len, LWIP_HTTPD_MAX_TAG_INSERT_LEN - len - 1,"vTaskGetRunTimeStats\n");
    vTaskGetRunTimeStats(insert + len);
    len += strlen(insert);
    len += snprintf(insert + len, LWIP_HTTPD_MAX_TAG_INSERT_LEN - len - 1,"\n\nvTaskList\n");
    vTaskList(insert + len);
    len += strlen(insert);
    len += snprintf(insert + len, LWIP_HTTPD_MAX_TAG_INSERT_LEN - len - 1,"\n\nxTaskGetTickCount() %lu\n",xTaskGetTickCount());
    return len;
    //return snprintf(insert, LWIP_HTTPD_MAX_TAG_INSERT_LEN - 2, "I bims vong terst inne tag 2 her");
  }else if(index == 1){//CONFIG
    return config_read(insert, LWIP_HTTPD_MAX_TAG_INSERT_LEN);
  }else if(index == 2){//NAME
    config_get_string("name", insert);
    return strnlen(insert, LWIP_HTTPD_MAX_TAG_INSERT_LEN);
  }
  else if (index == 3)
  { //PACKETCOUNTER
    return snprintf(insert, LWIP_HTTPD_MAX_TAG_INSERT_LEN - 2, "IP packet counter:\nMMCTGFCR: %u\nMMCTGFMSCCR: %u\nMCTGFSCCR: %u\nMMCRGUFCR: %u\nMMCRFAECR: %u\nMMCRFCECR: %u \nxPortGetFreeHeapSize: %d\nxPortGetMinimumEverFreeHeapSize: %d", ETH->MMCTGFCR, ETH->MMCTGFMSCCR, ETH->MMCTGFSCCR, ETH->MMCRGUFCR, ETH->MMCRFAECR, ETH->MMCRFCECR, xPortGetFreeHeapSize(), xPortGetMinimumEverFreeHeapSize());
  }
  else if (index == 4)
  { //PHASOR
    extern struct ade_float_t ade_f;
    int len =  snprintf(insert, LWIP_HTTPD_MAX_TAG_INSERT_LEN - 2,
                    "{\"status\": [%d,%d], "
                    "\"U\": {\"L1\": %.2f, \"L2\": %.2f, \"L3\": %.2f, \"L1(one)\": %.2f, \"L2(one)\": %.2f, \"L3(one)\": %.2f, \"L1(1012)\": %.2f, \"L2(1012)\": %.2f, \"L3(1012)\": %.2f}, "
                    "\"ang_U\":{ \"L2\":%.2f, \"L3\": %.2f}, "
                    "\"ang_I\":{ \"L1\":%.2f, \"L2\": %.2f, \"L3\": %.2f}, "
                    "\"I\": {\"L1\": %.2f, \"L2\": %.2f, \"L3\": %.2f, \"N\": %.2f, \"L1(one)\": %.2f, \"L2(one)\": %.2f, \"L3(one)\": %.2f, \"N(one)\": %.2f, \"L1(1012)\": %.2f, \"L2(1012)\": %.2f, \"L3(1012)\": %.2f, \"N(1012)\": %.2f, \"ISUMRMS\": %.4f},"
                    "\"P\": {\"L1\": %.2f, \"L2\": %.2f, \"L3\": %.2f, \"L1f\": %.2f, \"L2f\": %.2f, \"L3f\": %.2f},"
                    "\"Q\": {\"L1\": %.2f, \"L2\": %.2f, \"L3\": %.2f, \"L1f\": %.2f, \"L2f\": %.2f, \"L3f\": %.2f},"
                    "\"S\": {\"L1\": %.2f, \"L2\": %.2f, \"L3\": %.2f, \"L1f\": %.2f, \"L2f\": %.2f, \"L3f\": %.2f},"
                    "\"Energy\": {\"L1\": %.6f, \"L2\": %.6f, \"L3\": %.6f}"
                    //"\"pf\": {\"L1\": %.2f, \"L2\": %.2f, \"L3\": %.2f},"
                    "}",
                    ade_f.status0, ade_f.status1,
                    ade_f.avrms, ade_f.bvrms, ade_f.cvrms, ade_f.avrmsone, ade_f.bvrmsone, ade_f.cvrmsone, ade_f.avrms1012, ade_f.bvrms1012, ade_f.cvrms1012,
                    ade_f.angl_va_vb, ade_f.angl_va_vc,
                    ade_f.angl_va_ia, ade_f.angl_vb_ib, ade_f.angl_vc_ic,
                    ade_f.airms, ade_f.birms, ade_f.cirms, ade_f.nirms, ade_f.airmsone, ade_f.birmsone, ade_f.cirmsone, ade_f.nirmsone, ade_f.airms1012, ade_f.birms1012, ade_f.cirms1012, ade_f.nirms1012, ade_f.isumrms,
                    ade_f.awatt, ade_f.bwatt, ade_f.cwatt, ade_f.afwatt, ade_f.bfwatt, ade_f.cfwatt,
                    ade_f.avar, ade_f.bvar, ade_f.cvar, ade_f.afvar, ade_f.bfvar, ade_f.cfvar,
                    ade_f.ava, ade_f.bva, ade_f.cva, ade_f.afva, ade_f.bfva, ade_f.cfva,
                    ade_f.kwh_a, ade_f.kwh_b, ade_f.kwh_c
                    //ade_f.apf, ade_f.bpf, ade_f.cpf
                    );
      return len;
  } else if(index == 5) {//VERSION
    extern volatile const version_info_t version_info_stmbl;
    uint32_t len = 0;
    len += snprintf(insert + len, LWIP_HTTPD_MAX_TAG_INSERT_LEN - len - 1,"%s v%i.%i.%i %s\n",
      version_info_stmbl.product_name,
      version_info_stmbl.major,
      version_info_stmbl.minor,
      version_info_stmbl.patch,
      version_info_stmbl.git_version);
    len += snprintf(insert + len, LWIP_HTTPD_MAX_TAG_INSERT_LEN - len - 1,"Branch %s\n", version_info_stmbl.git_branch);
    len += snprintf(insert + len, LWIP_HTTPD_MAX_TAG_INSERT_LEN - len - 1,"Compiled %s %s ", version_info_stmbl.build_date, version_info_stmbl.build_time);
    len += snprintf(insert + len, LWIP_HTTPD_MAX_TAG_INSERT_LEN - len - 1,"by %s on %s\n", version_info_stmbl.build_user, version_info_stmbl.build_host);
    len += snprintf(insert + len, LWIP_HTTPD_MAX_TAG_INSERT_LEN - len - 1,"GCC        %s\n", __VERSION__);
    len += snprintf(insert + len, LWIP_HTTPD_MAX_TAG_INSERT_LEN - len - 1,"newlib     %s\n", _NEWLIB_VERSION);
    len += snprintf(insert + len, LWIP_HTTPD_MAX_TAG_INSERT_LEN - len - 1,"size: %lu crc:%lx\n", version_info_stmbl.image_size, version_info_stmbl.image_crc);
    return len;
  } else if(index == 6) {//RESET
    HAL_NVIC_SystemReset();
    return 0;
  }

  return 0;
}

void vApplicationStackOverflowHook(TaskHandle_t *pxTask, char *pcTaskName)
{
    taskDISABLE_INTERRUPTS();
    SEGGER_RTT_printf(0, "StackOverflow in %s\n",pcTaskName);
    for(;;);
}

/* USER CODE END 0 */

/**
  * @brief  The application entry point.
  * @retval int
  */
int main(void)
{
  /* MCU Configuration--------------------------------------------------------*/

  /* Reset of all peripherals, Initializes the Flash interface and the Systick. */
  HAL_Init();

  /* Configure the system clock */
  SystemClock_Config();

  /* Initialize all configured peripherals */
  MX_GPIO_Init();
  MX_RTC_Init();
  MX_SPI1_Init();
  MX_SDIO_SD_Init();
  MX_I2C1_Init();
  MX_CRC_Init();

  //debug: 95,96,97,98
  //pb8, pb9,pe0, pe1
  __HAL_RCC_GPIOE_CLK_ENABLE();
  __HAL_RCC_GPIOB_CLK_ENABLE();
    GPIO_InitTypeDef GPIO_InitStruct = {0};
  GPIO_InitStruct.Pin = GPIO_PIN_1 | GPIO_PIN_1;
  GPIO_InitStruct.Mode = GPIO_MODE_OUTPUT_PP;
  GPIO_InitStruct.Pull = GPIO_NOPULL;
  GPIO_InitStruct.Speed = GPIO_SPEED_FREQ_MEDIUM;
  HAL_GPIO_Init(GPIOE, &GPIO_InitStruct);
    GPIO_InitStruct.Pin = GPIO_PIN_8 | GPIO_PIN_9;
  GPIO_InitStruct.Mode = GPIO_MODE_OUTPUT_PP;
  GPIO_InitStruct.Pull = GPIO_NOPULL;
  GPIO_InitStruct.Speed = GPIO_SPEED_FREQ_MEDIUM;
  HAL_GPIO_Init(GPIOB, &GPIO_InitStruct);

  /* USER CODE BEGIN 2 */
  MX_LWIP_Init();
  ETH->MMCRIMR |= ETH_MMCRIMR_RGUFM | ETH_MMCRIMR_RFAEM   | ETH_MMCRIMR_RFCEM;
  ETH->MMCTIMR |= ETH_MMCTIMR_TGFM  | ETH_MMCTIMR_TGFMSCM | ETH_MMCTIMR_TGFSCM;

  http_set_ssi_handler((tSSIHandler) ssi_handler, (char const **)tags, LWIP_ARRAYSIZE(tags));
  httpd_init();

  SEGGER_RTT_Init();
  SEGGER_RTT_printf(0, "yolo\n");

  xTaskCreate((TaskFunction_t)linktask, "linktask", configMINIMAL_STACK_SIZE * 2, NULL, configMAX_PRIORITIES - 1, NULL);
  fwupdate_init();

  xTaskCreate((TaskFunction_t)LEDBlink, "LED Keepalive", configMINIMAL_STACK_SIZE, NULL, configMAX_PRIORITIES - 3, NULL);
  xTaskCreate((TaskFunction_t)SPI_get_data, "Get ADE values", configMINIMAL_STACK_SIZE * 2, NULL, configMAX_PRIORITIES - 2, NULL);
  influx_init();
  //dmr_task_init();


  SEGGER_RTT_printf(0, "Tasks running\n");

  /* USER CODE END 2 */

  /* Start scheduler */
  osKernelStart();

  /* We should never get here as control is now taken by the scheduler */

  /* Infinite loop */
  /* USER CODE BEGIN WHILE */
  while (1)
  {
    /* USER CODE END WHILE */

    /* USER CODE BEGIN 3 */
  }
  /* USER CODE END 3 */
}

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
/**
  * @brief  Period elapsed callback in non blocking mode
  * @note   This function is called  when TIM1 interrupt took place, inside
  * HAL_TIM_IRQHandler(). It makes a direct call to HAL_IncTick() to increment
  * a global variable "uwTick" used as application time base.
  * @param  htim : TIM handle
  * @retval None
  */
void HAL_TIM_PeriodElapsedCallback(TIM_HandleTypeDef *htim)
{
  if (htim->Instance == TIM1)
  {
    HAL_IncTick();
  }
}

/**
  * @brief  This function is executed in case of error occurrence.
  * @retval None
  */
void Error_Handler(void)
{
  /* USER CODE BEGIN Error_Handler_Debug */
  /* User can add his own implementation to report the HAL error return state */

  /* USER CODE END Error_Handler_Debug */
}

#ifdef USE_FULL_ASSERT
/**
  * @brief  Reports the name of the source file and the source line number
  *         where the assert_param error has occurred.
  * @param  file: pointer to the source file name
  * @param  line: assert_param error line source number
  * @retval None
  */
void assert_failed(uint8_t *file, uint32_t line)
{
  /* USER CODE BEGIN 6 */
  /* User can add his own implementation to report the file name and line number,
     tex: printf("Wrong parameters value: file %s on line %d\r\n", file, line) */
  /* USER CODE END 6 */
}
#endif /* USE_FULL_ASSERT */

/************************ (C) COPYRIGHT STMicroelectronics *****END OF FILE****/
