Sync-/powermetering/software/powermetering/powermetering.ioc

Mcu.UserName=STM32F407VGTx
PA1.Signal=ETH_REF_CLK
PA11.Signal=USB_OTG_FS_DM
PA12.Signal=USB_OTG_FS_DP
PA13.Signal=SYS_JTMS-SWDIO
PA14.Signal=SYS_JTCK-SWCLK
PA2.Signal=ETH_MDIO
PA5.Signal=SPI1_SCK
PA6.Signal=SPI1_MISO
PA7.Signal=ETH_CRS_DV
PA8.Signal=RCC_MCO_1
PB11.Signal=ETH_TX_EN
PB12.Signal=ETH_TXD0
PB13.Signal=ETH_TXD1
PB14.GPIO_Label=ADE_CS
PB14.Signal=GPIO_Output
PB5.Signal=SPI1_MOSI
PB7.Signal=GPIO_Input
PB8.Signal=I2C1_SCL
PB9.Signal=I2C1_SDA
PC1.Signal=ETH_MDC
PC10.Signal=SDIO_D2
PC11.Signal=SDIO_D3
PC12.Signal=SDIO_CK
PC14-OSC32_IN.Signal=RCC_OSC32_IN
PC15-OSC32_OUT.Signal=RCC_OSC32_OUT
PC4.Signal=ETH_RXD0
PC5.Signal=ETH_RXD1
PC8.Signal=SDIO_D0
PC9.Signal=SDIO_D1
PD2.Signal=SDIO_CMD
PD5.Signal=USART2_TX
PD6.Signal=USART2_RX
PE0.Signal=GPIO_Output
PE1.Signal=GPIO_Output
PE2.GPIO_Label=LED3
PE2.Signal=GPIO_Output
PE3.GPIO_Label=LED2
PE3.Signal=GPIO_Output
PE4.GPIO_Label=LED1
PE4.Signal=GPIO_Output
PH0-OSC_IN.Signal=RCC_OSC_IN
PH1-OSC_OUT.Signal=RCC_OSC_OUT
