Sync-/powermetering/software/powermetering/Core/Inc/main.h

#define LED3_Pin GPIO_PIN_2
#define LED3_GPIO_Port GPIOE
#define LED2_Pin GPIO_PIN_3
#define LED2_GPIO_Port GPIOE
#define LED1_Pin GPIO_PIN_4
#define LED1_GPIO_Port GPIOE
#define ADE_CS_Pin GPIO_PIN_14
#define ADE_CS_GPIO_Port GPIOB
