Sync-/powermetering/software/powermetering/Core/Src/version_stmbl.c

#include "version_stmbl.h"

volatile const version_info_t version_info_stmbl __attribute__((section(".version_info"))) = {
    .product_name = "powermetering",
    .major        = 0,
    .minor        = 1,
    .patch        = 0};
