Sync-/powermetering/(commit log)

2019-01-04 first steps
    [powermetering.kicad_pcb, powermetering.sch]
2019-04-24 repair schematic, change pcb outline to spelsberg tk1111
    [powermetering.sch]
2019-04-24 add stm32, ethernet phy, hv supply with lnk304
    [hv_supply.sch, phy_plug.sch, powermetering.kicad_pcb, powermetering.sch, stm32.sch]
2019-04-25 remove xfmrs from top board, no space with 18650 backup battery
    [powermetering.kicad_pcb, powermetering.sch, stm32.sch]
2019-04-25 start adding liion charger circuit
    [powermetering.kicad_pcb, powermetering.sch]
2019-04-27 add some 3d models
    [powermetering.kicad_pcb, powermetering.sch]
2019-04-28 Change to bigger housing
    [hv_supply.sch, phy_plug.sch, powermetering.kicad_pcb, powermetering.sch, stm32.sch]
2019-05-16 add supply and AFE isolation
    [phy_plug.sch, powermetering.kicad_pcb, powermetering.sch, stm32.sch, supply.sch]
2019-05-16 eth phy
    [phy_plug.sch, powermetering.kicad_pcb, powermetering.sch, stm32.sch]
2019-05-17 finish routing of bottom board
    [powermetering.kicad_pcb, powermetering.sch, stm32.sch]
2019-05-18 finalize proto board and add second board outline
    [powermetering.kicad_pcb, powermetering.sch]
2019-06-20 move fuses, add power header
    [powermetering.kicad_pcb, powermetering.sch, supply.sch]
2019-06-24 displays voltage values through http
2019-06-25 V2 hardware
    [phy_plug.sch, powermetering.kicad_pcb, powermetering.sch, stm32.sch]
2019-06-25 swap phase order on current input
    [phy_plug.sch, powermetering.kicad_pcb, powermetering.sch]
2019-07-03 small changes
    [powermetering.kicad_pcb]
2019-07-03 add EMI capacitor
    [phy_plug.sch, powermetering.kicad_pcb, powermetering.sch, stm32.sch]
2019-07-04 add sd card holder
    [powermetering.kicad_pcb, powermetering.sch, stm32.sch]
2019-07-05 add bodge pads and move stuff around
    [powermetering.kicad_pcb, powermetering.sch, stm32.sch]
2019-07-05 add ade reset jumper
    [powermetering.kicad_pcb, powermetering.sch]
2019-07-08 make it work™
2019-07-11 fix strange SPI issue ❓❗
    [main.c]
2019-07-15 small production changes
    [phy_plug.sch, powermetering.kicad_pcb, powermetering.sch]
2019-07-16 current version
2019-07-21 Fix 32bit write byte order
    [main.c]
2019-07-21 Move ADE init and add calibration for the development unit
2019-07-21 Activate ssi again + small changes™
2019-08-31 fix SD card socket, move around psu stuff
    [phy_plug.sch, powermetering.kicad_pcb, powermetering.sch, stm32.sch]
2019-11-24 added us timer so vTaskGetRunTimeStats and vTaskList can be used, increased max tag insert len
2019-11-30 fix allowed chars in config string
    [config.c]
2019-12-01 fix mac irq overflow
    [main.c]
2019-12-03 fix possible bug on config write and typo in frequency measurement
    [main.c]
2019-12-05 fix json url, rename tasks, add free mem to status page
    [fwupdate.c, main.c]
2019-12-06 limit amount of digits in data json and get fault current working
2019-12-06 add kicad lib tables
2019-12-10 fix stack sizes, fix malloc lock
    [influx.c, main.c]
2019-12-23 change ade read to dma
2019-12-23 enable SYS_LIGHTWEIGHT_PROT increase buffer size add delay in read spi
2019-12-28 print ip on startup
2019-12-29 add reset page, add cur_pri config option
    [ade.c, ade.h, main.c]
2020-01-04 added power calculation
2020-01-04 Fixed S VA and Q VAR mapping
    [main.c]
2020-01-04 Added Power values to influx
2020-01-22 remove eight pulse rectifier, add three pulse rectifier with artificial star point
    [phy_plug.sch, powermetering.kicad_pcb, powermetering.sch, stm32.sch]
2020-07-08 add calibration data to config
2020-07-08 read power factor from register
2022-05-27 fix gcc10 support (extern hcrc, errno-include-foo)
    [fwupdate.c]
2023-08-16 reconfigure ade on config change, calculate calibration values
2023-08-16 Implement phase switch
