Sync-/powermetering/(notices)

Notices in the files:
software/powermetering/MBEDTLS/App/mbedtls_config.h:
© Copyright (c) 2019 STMicroelectronics.
All rights reserved.
This software component is licensed by ST under Ultimate Liberty license
